bitboxelectronics/R2C2_Hardware/v1.2/Project Outputs for PCB_Project1/Bill of Materials-PCB_Project1.xls

LibRef | Comment | Description | Designator | Footprint | Quantity | Populate
10000001 | 10uF 6.3V | Capacitor - MLCC; 0805; Y5V; 10UF; 6.3V | C4, C6, C22, C24, C38, C40 | CAPC2012M | 6.0
10000002 | 10uF 35V | Capacitor - MLCC; 10uF; 35V; | C41, C64 | CAPC3216M | 2.0
10000005 | 47uF 6.3V | Capacitor - MLCC Y5V; 47UF; 6.3V | C57 | CAPCP3825M | 1.0
10000006 | 2200uF 35V | Capacitor - Al. Electrolytic; 2200uF; 35V | C65, C66 | CAPPR7.5-16x25 | 2.0
10000007 | Orange | Led - 1206; Orange OSRAM | D13 | LEDM_3216X12M | 1.0
10000008 | Green | Led - 1206; Green OSRAM | D1, D4, D7 | LEDM_3216X12M | 3.0
10000009 | 25V@2A | Diode - Schottky; 25V; 2A | D12 | SMB | 1.0
10000010 | 60V@1.5A | Diode - Schottky; 1.5A; 60V | D11, D15, D16 | SMA | 3.0
10000011 | 3.15A | Fuse - 0603; Itrip=3.15A | F1 | RESC1608M | 1.0
10000013 | IC LPC175x | IC - uController ARM Cortex-M3, 100MHz | U5 | TSQFP50P1400X1400X160-80M | 1.0
10000017 | IC L5970D | IC - DC-DC Reg. | U6 | SOIC127P600-8M | 1.0
10000019 | SW-PB | Switch - Micro; Tactile; SPNO | S1, S2 | SW_FSM6JSMA | 2.0
10000023 | Con 4 | Connector - Header male; Screw; 4way; Hor. | J1, J2, J4, J5, J7, J8 | WEIDMULLER_SL-5.08-04-90B | 6.0
10000029 | uSD | Connector - MicroSD Card 8pin; PCB; Gold | J10 | 3M_2900 | 1.0
10000032 | 470R@100Mhz | Ferrite Bead - 470OHM; 0603 | L1, L2, L3, L4, L5, L6, L7, L8, L9, L10, L11, L12 | INDC1608M | 12.0
10000039 | N | Mosfet - N; 60V; 0.3A; | Q1, Q2, Q3, Q4, Q8, Q10, Q12, Q13 | SOT323-3AM | 8.0
10000040 | 12MHz | Crystal - 12.0MHz | X2 | HC49/4H_SMX | 1.0
10000041 | 274R | Resistor, Resistor - 0603; 0.063W; 1% | R13, R16, R17, R42, R45, R46, R60, R61 | RESC1608M | 8.0
10000042 | 100R | Resistor - 0603; 0.063W; 1% | R11, R44, R62, R68, R69, R96, R107 | RESC1608M | 7.0
10000044 | 10K | Resistor, Resistor - 0603; 0.063W; 1% | R1, R2, R3, R6, R7, R8, R9, R10, R12, R26, R27, R30, R31, R32, R33, R35, R36, R37, R38, R41, R55, R57, R59, R64, R70, R71, R72, R75, R76, R77, R83, R86, R89, R92, R94, R97, R104, R115 | RESC1608M | 38.0
10000045 | 100K | Resistor - 0603; 0.063W; 1% | R24, R25, R53, R54, R63, R65, R74, R99, R103 | RESC1608M | 9.0
10000047 | 0R047 | Resistor - 1206; 0.5W; 1% | R20, R21, R22, R23, R49, R50, R51, R52 | RESC3216M | 8.0
10000048 | 1K5 | Resistor, Resistor - 0603; 0.063W; 1% | R4, R43, R84, R85, R87, R106, R116 | RESC1608M | 7.0
10000049 | 1M | Resistor - 0603; 0.063W; 1% | R15, R100 | RESC1608M | 2.0
10000050 | 4K7 | Resistor - 0603; 0.063W; 1% | R66, R67, R95 | RESC1608M | 3.0
10000053 | 33R | Resistor - 0603; 0.063W; 1% | R90, R91 | RESC1608M | 2.0
10000054 | 100nF | Capacitor - MLCC; 0603; NP0; 50V, Capacitor Non Polarized | C1, C2, C3, C5, C7, C8, C9, C10, C13, C14, C17, C18, C19, C20, C21, C23, C25, C26, C28, C29, C30, C32, C35, C36, C37, C39, C43, C44, C45, C46, C47, C48, C59, C60, C62, C69, C70 | CAPC1608M | 37.0
10000055 | 220pF | Capacitor - MLCC; 0603; NP0; 50V | C67 | CAPC1608M | 1.0
10000056 | 22pF | Capacitor - MLCC; 0603; NP0; 50V | C42, C55, C56, C68 | CAPC1608M | 4.0
10000057 | 10nF | Capacitor - MLCC; 0603; NP0; 50V | C51, C54, C71, C72, C73 | CAPC1608M | 5.0
10000058 | 1nF | Capacitor - MLCC; 0603; NP0; 50V | C50, C53 | CAPC1608M | 2.0
10000059 | 220nF | Capacitor - MLCC; 0603; NP0; 50V | C15, C16, C33, C34 | CAPC1608M | 4.0
10000061 | 680R | Resistor - 0603; 0.063W; 1% | R93, R98 | RESC1608M | 2.0
10000062 | RJ11 | Connector - PCB; RJ11; 6/4 Low Profile; Hor. | J3, J6, J9 | MOLEX_95022-2667 | 3.0
10000064 | 2x10x2.54mm | Connector - PCB; Male Receptacle; 2.54mm; 2way; Vert. | J22 | HDR2X10 | 1.0
10000065 | Blue | Led - 1206; Blue OSRAM | D10 | LEDM_3216X12M | 1.0
10000066 | 22nF | Capacitor - MLCC; 0603; NP0; 50V | C61 | CAPC1608M | 1.0
10000067 | Con 15 | Connector - Header 15x1 | J18, J20 | HDR1X15 | 2.0
10000068 | Buzzer | Buzzer - Piezo; 70dB; Diam.17mm | LS1 | TDK_PS17 | 1.0
10000069 | 100uF 50V | Capacitor - Al. Electrolytic; 100UF; 50V | C11, C12, C27, C31 | CAPAE100X100M | 4.0
10000073 | Con 4 USB | Connector - USB; Type B; Hor; | J11 | USB2.5-2H4D | 1.0
10000074 | HDR1X6H | Connector - Header 1x6; Hor. | J19, J23 | HDR1X6H | 2.0
10000076 | P | Mosfet - Power; Vdss=-30v; Rds=0.60; Id=-0.6A | Q7, Q9, Q11 | SOT23-3M | 3.0
10000078 | N | N-channel Enhancement Mode Field-effect Transistor (123/gds) | Q5, Q6 | D2PAK | 2.0
10000079 | 2k2 1% | Resistor - 0603; 0.063W; 1% | R102 | RESC1608M | 1.0
10000080 | 6k8 1% | Resistor - 0603; 0.063W; 1% | R5, R101 | RESC1608M | 2.0
10000081 | 33uH 1.5Adc | Inductor - 33uH; Isat=2.9A; In=1.5A | L13 | INDP9898X58M | 1.0
10000082 | LDO | IC - Fixed LDO Voltage Reg 3.3V 800mA | U10 | SOT223-4M | 1.0
10000085 | 1A@30V | Diode - Schottky; 30V; 1A; | D19, D20, D21, D22, D23 | SOD323 | 5.0
10000086 | 100uF 10V | Capacitor - Al. Electrolytic; 100uF, 16V | C58, C63 | CAPAE6666X54M | 2.0
10000087 | 39K | Resistor - 0603; 0.063W; 1% | R18, R19, R47, R48 | RESC1608M | 4.0
10000088 | 12V | Diode - Zener; 0.4W; 12V | D17, D18 | SOD323 | 2.0
10000089 | Red | Led - 1206; Red | D2, D3, D5, D6, D8, D9 | LEDM_3216X12M | 6.0
10000090 | Mec_Heat_Sink | Heat Sink - IC stiker | HS1, HS2, HS3, HS4 | HS_180x130x50 | 4.0
10000091 | Mec_Heat_Sink | Heat Sink - For D2PAK | HS5 | FK_244_13_D2PAK | 1.0
10000092 | 10K | Resistor - Trimmer; 1/4"; 10K | P1, P2, P3, P4 | Trimmer_14 | 4.0
10000094 | A4988 | A4988 (A4983 pinout compatible) | U1, U2, U3, U4 | QFN50P500X500X100-28M | 4.0
10000095 | Con 3 |  | J17 | phoenix-contact_smkdsn-5.08 | 1.0
10000097 | Con 2 | Connector - PCB; Header; SQ Pin, 2 way; 2.54mm; Vert | J21, J24 | MOLEX_22-29-2021 | 2.0
10000098 | 6k8 | Resistor - 0805; 0.100W; 5% | R34, R39, R40, R73, R78, R79, R80, R81, R82, R108, R109, R110, R111, R112, R113, R114 | RESC2012L | 16.0
10000099 | - | Connector - PCB; Female Receptacle; 4 way; Hor. | J16 | KYCON_KPJX-4S | 1.0
10000045 | 100K | Resistor - 0603; 0.063W; 1% | R28, R29, R56, R58 | RESC1608M | 4.0 | NP
10000056 | 22pF | Capacitor - MLCC; 0603; NP0; 50V | C49, C52 | CAPC1608M | 2.0 | NP
10000063 | 32.768KHz | Crystal - 32.768 kHz Low Profile; PLastic | X1 | XTAL_800P380X250-4M | 1.0 | NP
10000093 | HDR1X6H |  | J12, J13, J14, J15 | HDR1X6 | 4.0 | NP
