bitboxelectronics/R2C2_Hardware/v1.2/Project Outputs for PCB_Project2/Bill of Materials-PCB_Project2.xls

LibRef | Comment | Description | Designator | Footprint | Quantity | Populate
10000001 | 10uF 6.3V | Capacitor - MLCC; 0805; Y5V; 10UF; 6.3V | C42 | CAPC2012M | 1.0
10000008 | Green | Led - 1206; Green OSRAM | D14 | LEDM_3216X12M | 1.0
10000054 | 100nF | Capacitor - MLCC; 0603; NP0; 50V | C68 | CAPC1608M | 1.0
10000061 | 680R | Resistor - 0603; 0.063W; 1% | R14, R88 | RESC1608M | 2.0
10000062 | RJ11 | Connector - PCB; RJ11; 6/4 Low Profile; Hor. | J16 | MOLEX_95022-2667 | 1.0
10000075 | Photo Switch | Opto - Switch; OPIC Sharp; Slotted 3mm; Vcc 5v | U7 | OPIC_122x50x10 | 1.0
10000061 | 680R | Resistor - 0603; 0.063W; 1% | R105 | RESC1608M | 1.0 | NP
