bitboxelectronics/R2C2_Hardware/v1.2/R2C2_v1.2_Schematics.pdf

D | D
C | C
B | B
A | A

Title

Size | Number | Revision
A3
Date: | 14-12-2011 | Sheet of
File: | \\..\Sheet_FrontPage.SchDoc | Drawn By: V1.2

## R2C2 - RepRapCncController

FMendes75@gmail.com

Creative Commons BY-NC-SA

www.3dprinting-r2c2.com

License

Project | R2C2 - RepRap CncController
Revision | 1.2
Date | 10/11/2011
License | Creative Commons BY-NC-SA

# bitBOX HW Release

## Optoswitch X

## Optoswitch Y

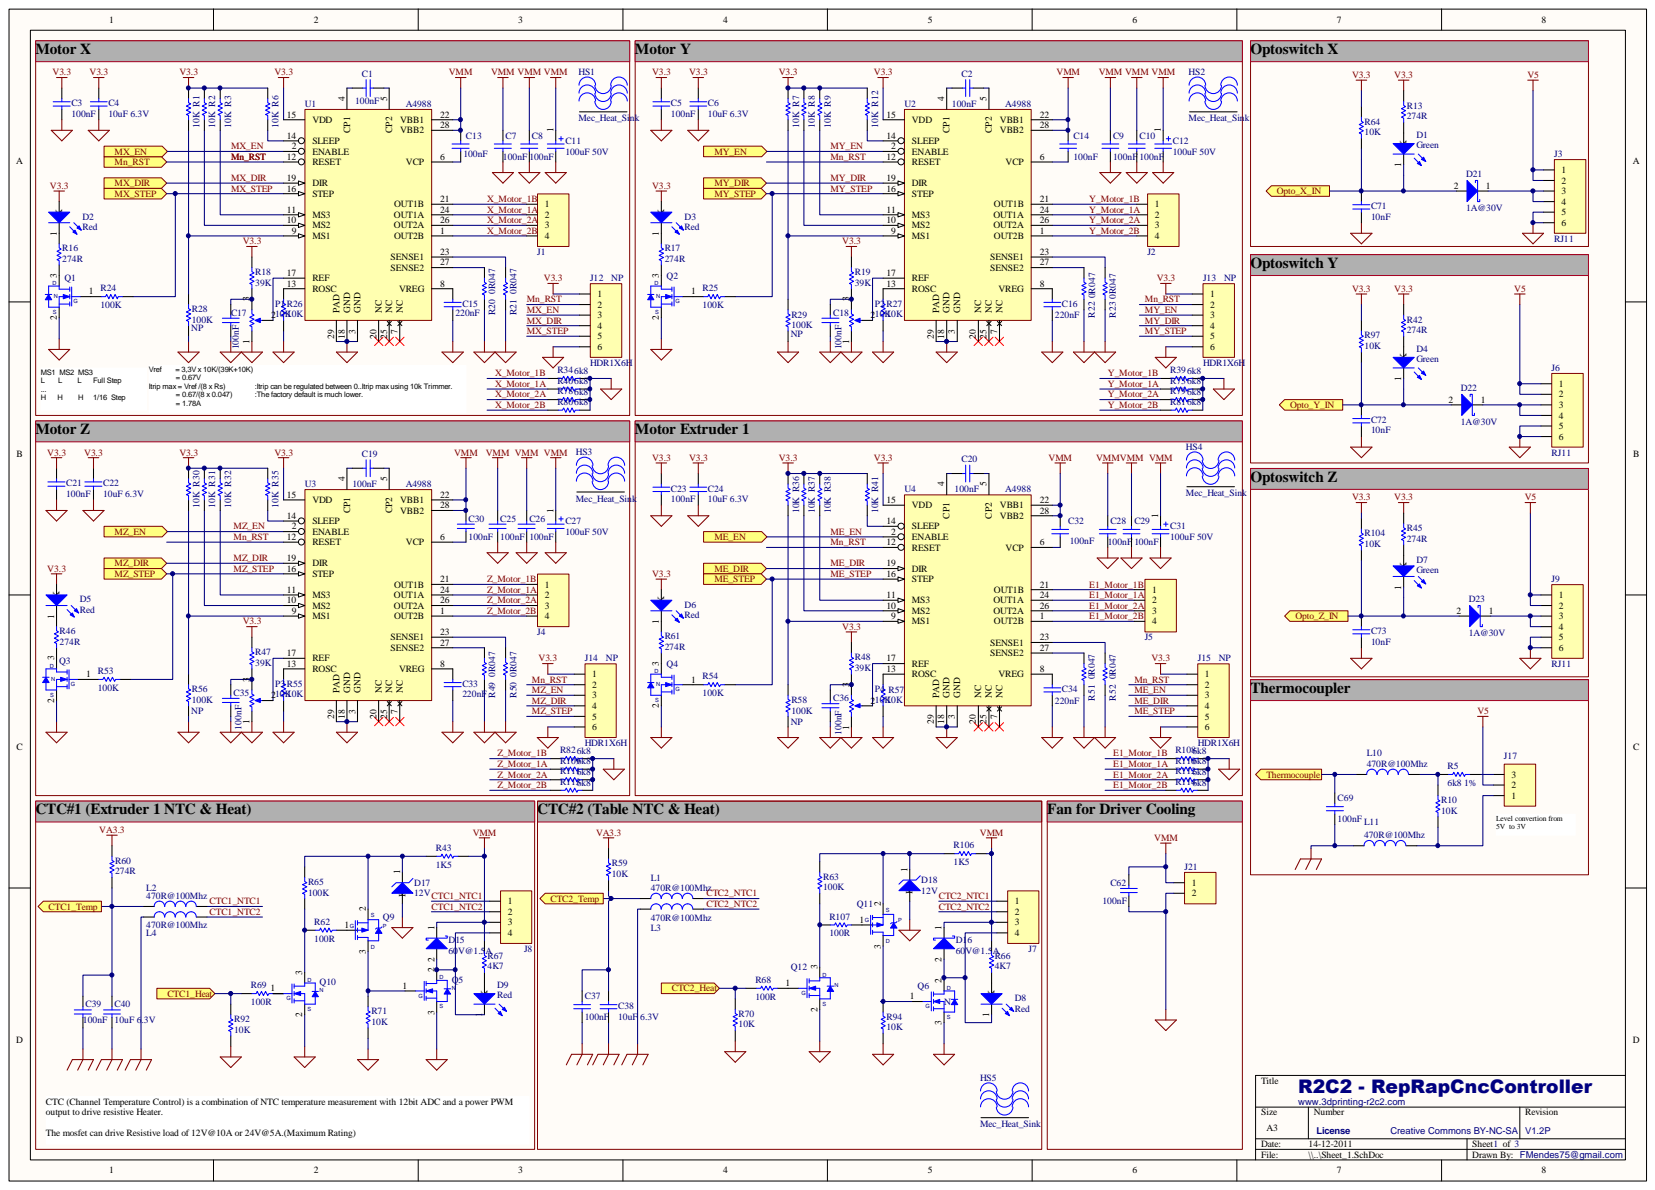
[picture p1: page 2]

CTC#1 (Extruder 1 NTC & Heat)

Fan for Driver Cooling

CTC (Channel Temperature Control) is a combination of NTC temperature measurement with 12bit ADC and a power PWM
output to drive resistive Heater.
The mosfet can drive Resistive load of 12V@10A or 24V@5A.(Maximum Rating)

## Processing

## Expansion

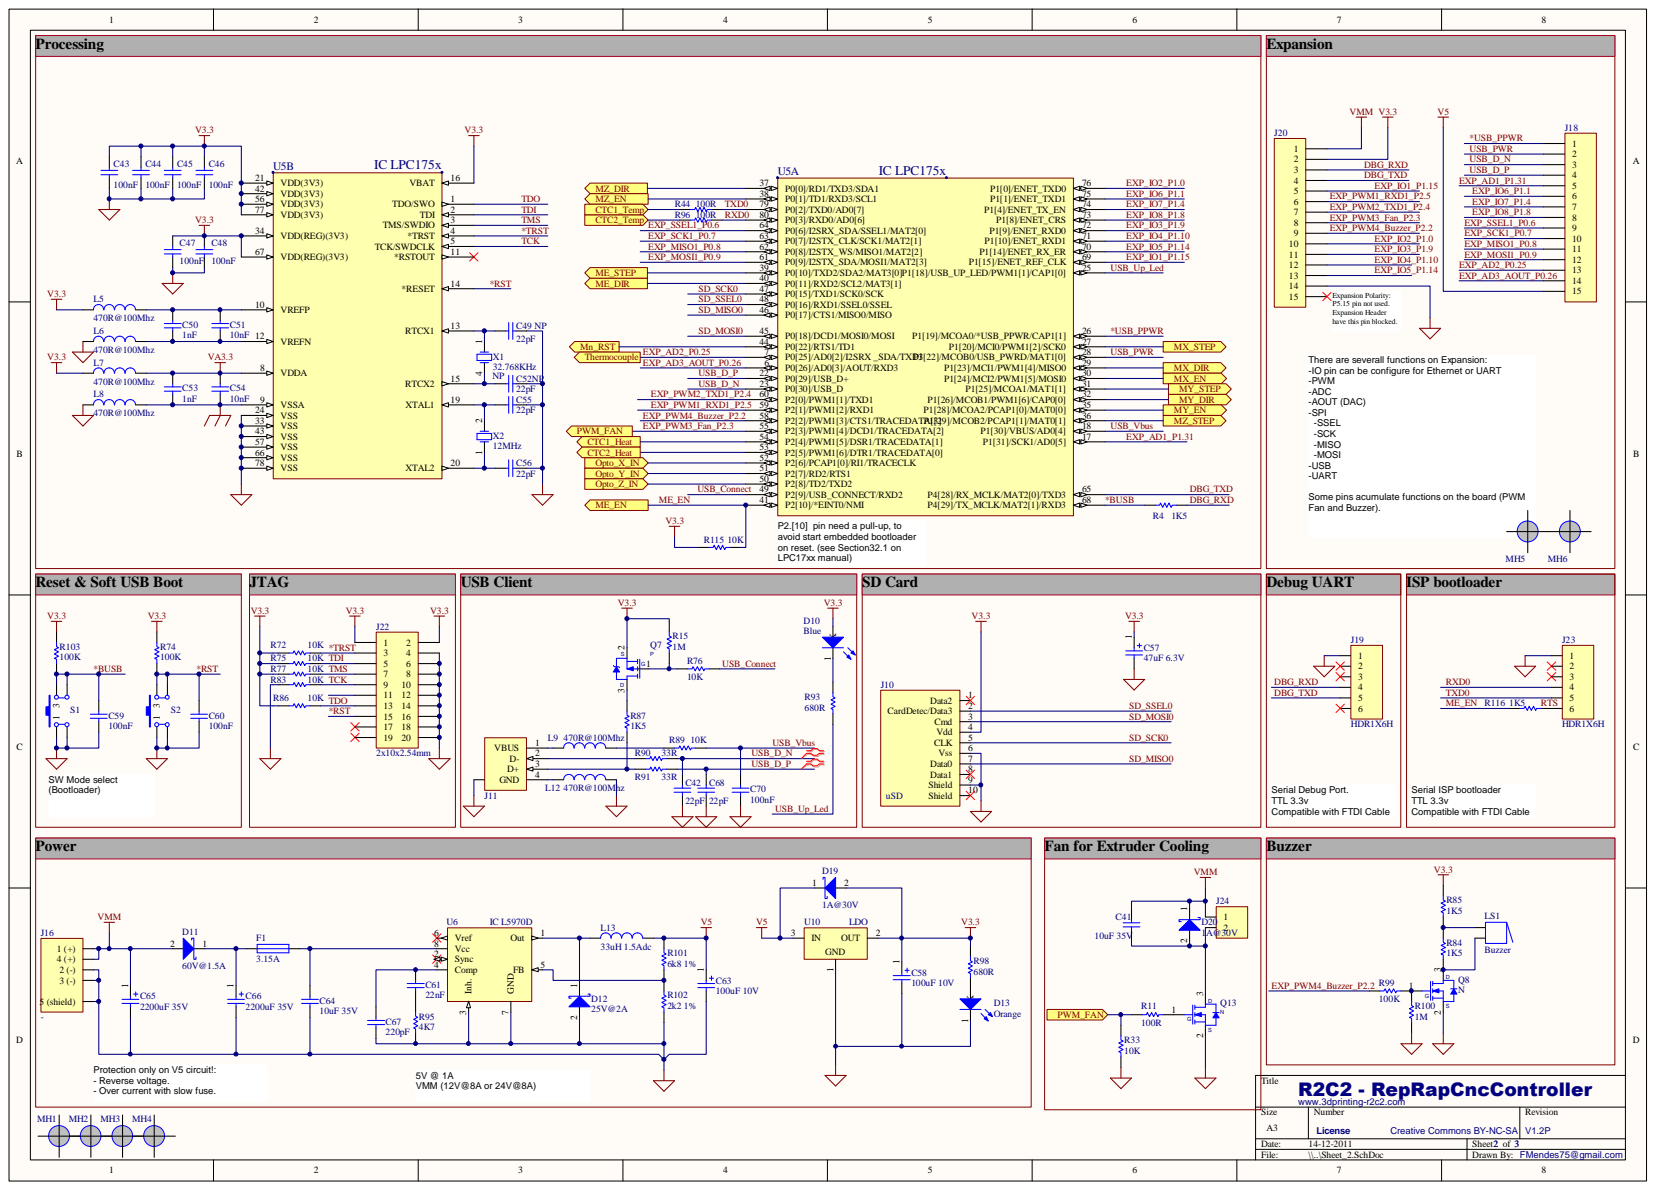
[picture p2: page 3]

Expansion Polarity:
P5.15 pin not used.
Expansion Header
have this pin blocked.

There are severall functions on Expansion:
-IO pin can be configure for Ethernet or UART
-PWM
-ADC
-AOUT (DAC)
-SPI
-SSEL
-SCK
-MISO
-MOSI
-USB
-UART

Some pins acumulate functions on the board (PWM
Fan and Buzzer).

P2.[10] pin need a pull-up, to
avoid start embedded bootloader
on reset. (see Section32.1 on
LPC17xx manual)

Reset & Soft USB Boot

Serial Debug Port.
TTL 3.3v
Compatible with FTDI Cable
Buzzer

Serial ISP bootloader

Fan for Extruder Cooling

Protection only on V5 circuit!:
- Reverse voltage.
- Over current with slow fuse.

## Optoswitch PCB X

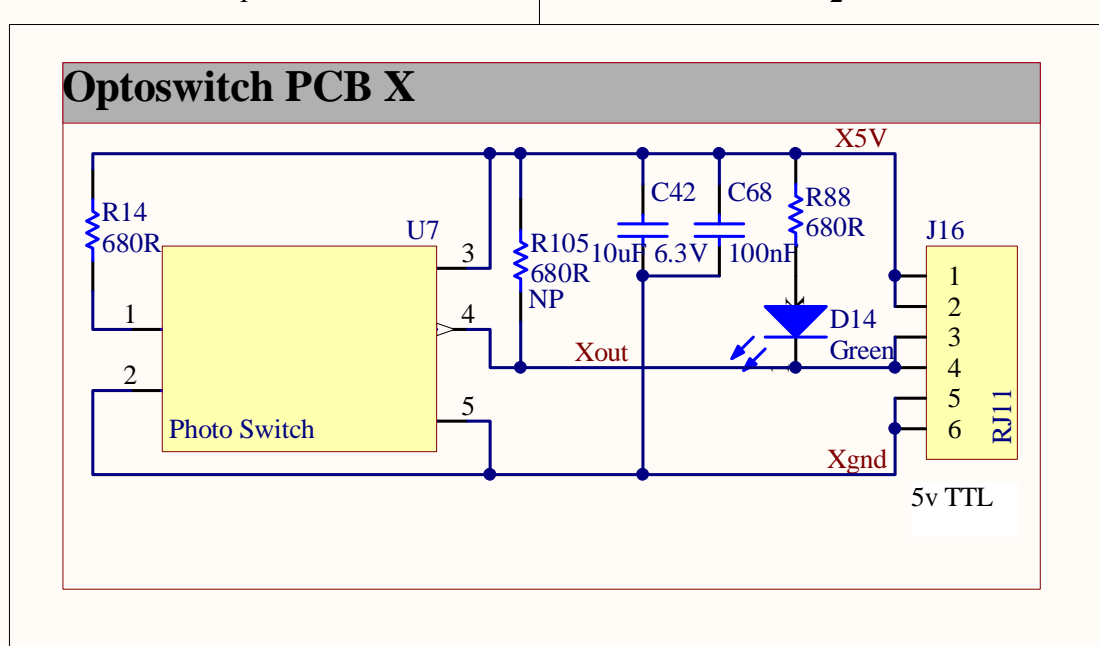
[picture p3: page 4]
