bitboxelectronics/R2C2_Hardware/(list of files, drawings)

Other design files:
v1.1P/project/PCB7_main_board.PcbDoc
v1.1P/project/PCB7_optoswitch.PcbDoc
v1.1P/project/PCB_Project.PrjPcb
v1.1P/project/Sheet_1.SchDoc
v1.1P/project/Sheet_2.SchDoc
v1.1P/project/Sheet_FromtPage.SchDoc
v1.2/PCB/PCB7_main_board.PcbDoc
v1.2/PCB/PCB7_optoswitch.PcbDoc
v1.2/PCB_Project1.PrjPCB
v1.2/PCB_Project2.PrjPCB
v1.2/Sheet_1.SchDoc
v1.2/Sheet_2.SchDoc
v1.2/Sheet_3.SchDoc
v1.2/Sheet_FrontPage.SchDoc
