bitboxelectronics/R2C2_Hardware/R2C2_module-bluetooth/R2C2_bluetooth.sch

## KiCad design R2C2_module-bluetooth/R2C2_bluetooth.sch (2011-11-03)

Schematic: R2C2_bluetooth.sch

Parts:
C1, C2: 100nF
D1, D2: LED
P1: J20
P2: J18
P3, P4: BLUETOOTH_MODULE
R1, R2: 470
