bitboxelectronics/R2C2_Hardware/(commit log)

2011-11-02 First time commit and added hardware to this repositorie.
    [PCB7_main_board.PcbDoc, PCB7_optoswitch.PcbDoc, PCB_Project.PrjPcb, Sheet_1.SchDoc, Sheet_2.SchDoc, Sheet_FromtPage.SchDoc]
2011-11-03 Added first revision of R2C2 module for Bluetooth.
    [R2C2_bluetooth.brd, R2C2_bluetooth.sch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]
2011-12-14 Added V1.2.
    [Bill of Materials-PCB_Project1.xls, Bill of Materials-PCB_Project2.xls, PCB7_main_board.PcbDoc, PCB7_optoswitch.PcbDoc, PCB_Project1.PrjPCB, PCB_Project2.PrjPCB, Sheet_1.SchDoc, Sheet_2.SchDoc]
